idunmore/phi2/README.md

# phi2 - Retro/Homebrew Computer Focused Clock Generators

&nbsp;

**phi2** is a collection of breadboard-buildable, highly-flexible, clock generators for retro/homebrew computers, using a minimal number of inexpensive and readily available micro-controllers, SBCs and other parts.

### Why "phi2"?

This is a reference to the clock input on my favorite early CPU/MPU, the [6502](https://en.wikipedia.org/wiki/MOS_Technology_6502). While 6502-based builds are *my* current focus, the clock generators here can be used with effectively any CPU/computer build.

## Structure of this Repository

A simple mono-repo, with sub-projects on a per-build basis.

Due to the typically resource-constrained nature of the smaller microcontrollers, and significant differences between architectures and, even within a common architecture, different capabilities and pin-outs, shared code is likely to be limited.  Thus each project may be considered a self-contained whole, unless otherwise noted.  This helps minimize code size and complexity and improves code readability by avoiding the otherwise-necessary multiple levels of conditional compilation that would otherwise be required.

Each individual project will include both hardware build details and diagrams along with ready-to-run firmware/software.

## Clock Features

These will vary per-project.

### [nano-clock](nano-clock/)

This is the first project in the series.

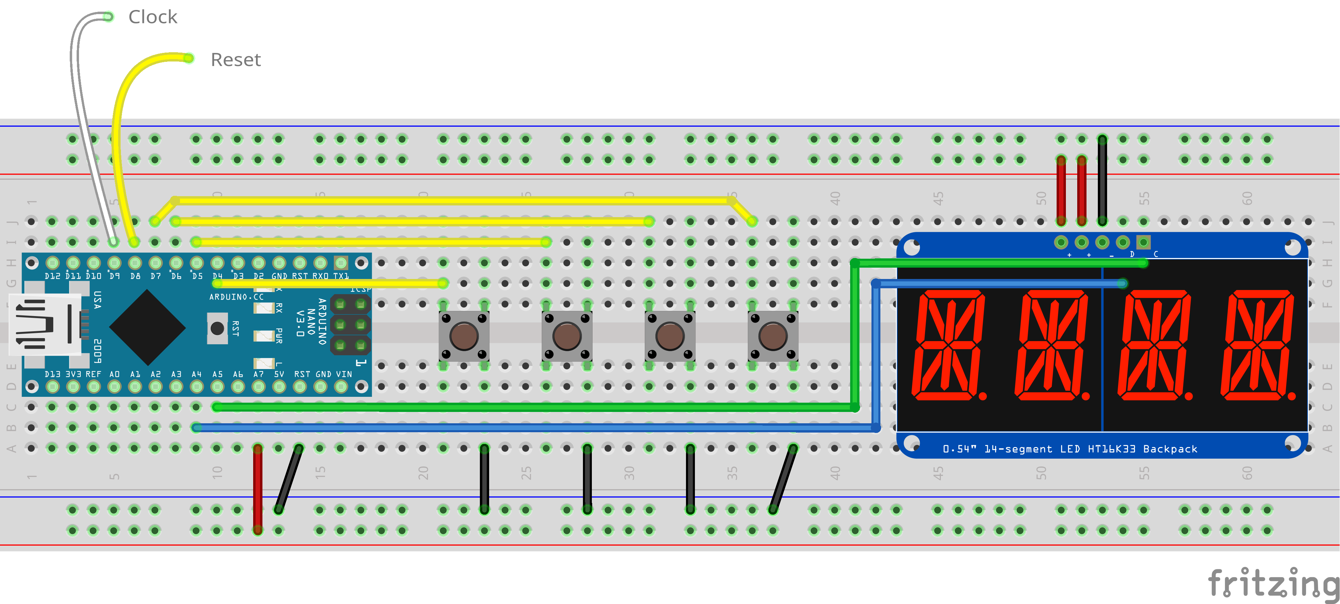
[picture p1: nano-clock/images/nano-clock_breadboard.png]
nano-clock breadboard layout


It has single-step and clock modes, run-stop toggle, selectable frequencies across three bands (Hz, kHz and MHz) in various increments from 1Hz to 8MHz, auto and manual reset functionality (with auto-reset on start option, configurable at run-time), a 14-segment 4-character LED status/info display (in keeping with the "retro" theme) with brightness control and run-time indicators.  This is a simple build, using just an Arduino Nano (an inexpensive clone will work fine) and four tactile buttons.

Advanced variations of this will incorporate different display technologies including tiny OLED and TFT color displays, and rich menu/graphical interfaces.

### [nano-clock-core](nano-clock-core/)

This 2nd, and almost the simplest (just the core capabilities), "phi2" project provides run-time selectable (and saveable) 1MHz, 2MHz, 4MHz and 8MHz clock frequencies, auto-starts when powered on, and offers a compile-time flag to enable/disable auto-reset behavior, and indicates operations using the built-in Arduino LED.  It requires only an Arduino Nano (or clone) and a single tactile button, which can be removed once an operating frequency has been selected and saved.

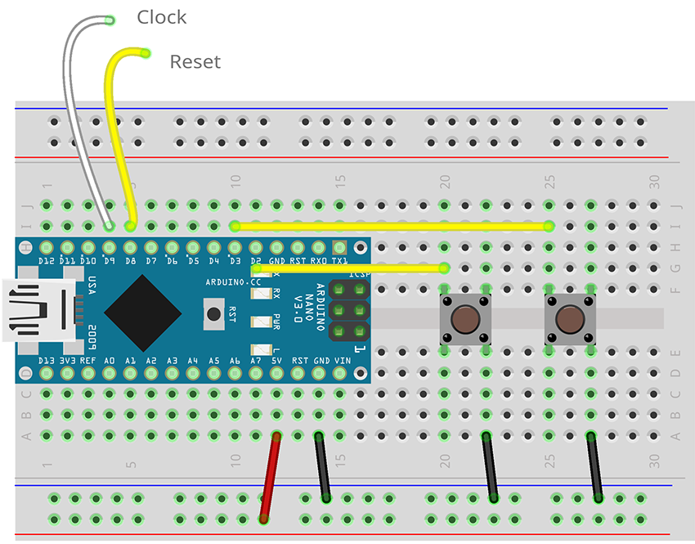
[picture p2: nano-clock-core/images/nano-clock-core_breadboard.png]
nano-clock-core breadboard layout


**nano-clock-core** is not much bigger than a standard 4-pin crystal oscillator can.

### [nano-clock-oled](nano-clock-oled/)

This is the 4th, and to-date most complex, "phi2" project.

It is based on my "[nano-clock](nano-clock/)" project, but instead of a 4-digit, 14-segment alphanumeric LED display it uses an small OLED panel on an I2C interface for status and operational messages. The initial version has the same functionality as the original, excepting a display on/off toggle in place of brightness control.

The display includes various status icons for which mode the clock is in (step vs. continuous clock), an animated waveform to indicate the clock is running, indicators for whether "reset on boot" is enabled, whether settings have been saved and if they've been changed since the last save.  And, finally, a large display that shows either the "step" pulse or the current clock frequency.

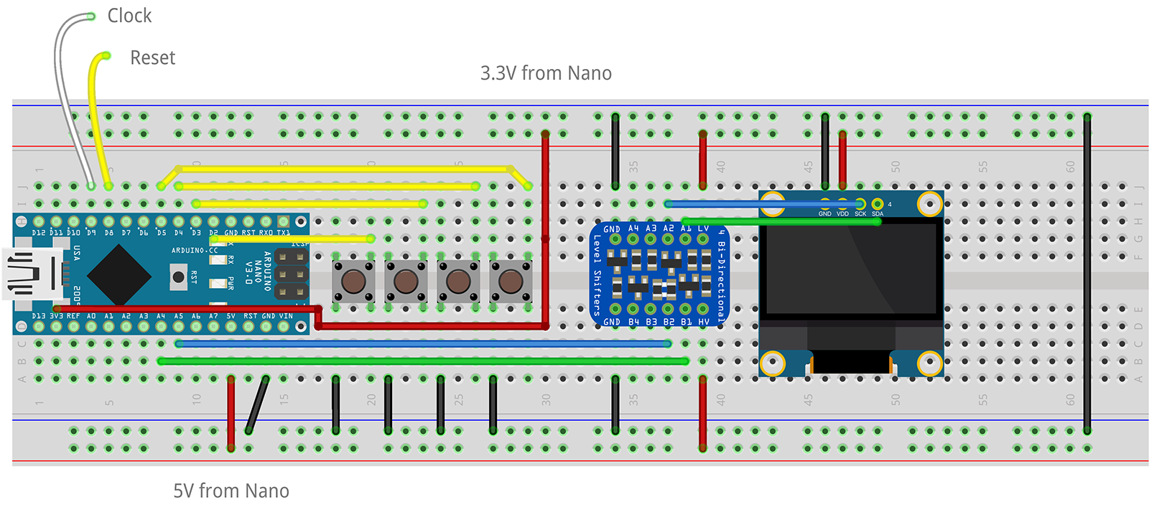
[picture p3: nano-clock-oled/images/nano-clock-oled_breadboard.png]
nano-clock-oled breadboard layout


### [tiny-clock](tiny-clock/)

The third clock build in the "phi2" series, and to date the simplest, departs from the typical "Arduino Board" based model and instead makes direct use of a "raw" microcontroller; in this case the [ATtiny85](https://ww1.microchip.com/downloads/en/DeviceDoc/Atmel-2586-AVR-8-bit-Microcontroller-ATtiny25-ATtiny45-ATtiny85_Datasheet.pdf).

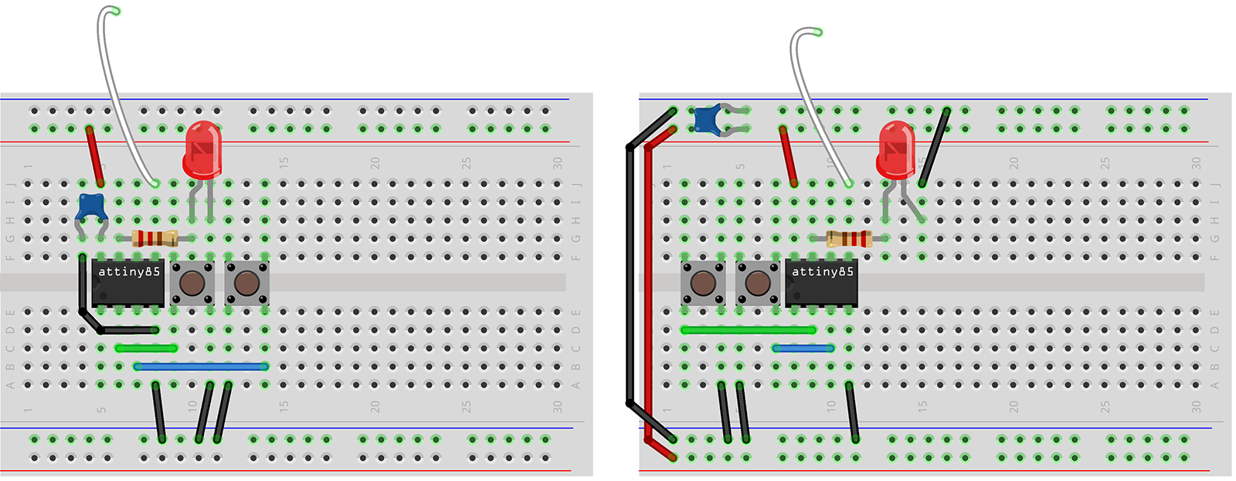
[picture p4: tiny-clock/images/tiny-clock_breadboard.png]
tiny-clock breadboard layout


The simplest build is **just** the ATTiny85 IC itself, an 8-pin DIP part that is **smaller** than the 4-pin crystal oscillator can in the standard BE6502 setup.  Optional, basic components (1 or 2 tactile buttons, and/or 1 resistor and LED), expand the basic clock generator behavior with run-time selectable (and saveable) 1MHz, 2MHz, 4MHz and 8MHz clock frequencies, an LED to indicate clock state/speed, and a single-step clock mode.

Settings can be saved by adding a button temporarily, and then can be removed.

## AI Usage

**None** for these projects, unless noted otherwise.

The goal wasn't to build them quickly, it was to have fun doing so and learn as much about the low-level hardware as possible.  That often means hand-optimized coding based on information buried deep in the datasheets for the raw microcontroller cores.

In most cases it also required a fair degree of manual tuning, changing values on the fly while observing output performance across several physical devices on a high-speed oscilloscope.  Variations within quoted tolerance are readily visible here.
