idunmore/phi2/nano-clock-oled/README.md

# nano-clock-oled - Arduino Nano based System Clock Gen

&nbsp;

**nano-clock-oled** is the fourth project in the "phi2" series.

It is based on my "[nano-clock](https://github.com/idunmore/phi2/tree/main/nano-clock)" project, but instead of a 4-digit, 14-segment alphanumeric LED display it uses an small OLED panel on an I2C interface for status and operational messages.  The initial version has the same functionality as the original, excepting a display on/off toggle in place of brightness control. Future iterations may add additional features or change display aesthetics, depending on available microcontroller RAM.

It provides a more flexible alternative to [Ben Eater's](https://eater.net) [6502 clock-module](https://eater.net/6502), both for single-step and slow-cycle operations as well as the ability to replace the final build's 1MHz crystal oscillator while offering faster clock speeds.

nano-clock-oled breadboard layout

## Features

- Single-step and Clock modes
- Run/Stop toggle
- Selectable frequencies across three bands (Hz, kHz and MHz)
  - Hz Band - 1, 2, 5, 10, 25, 50, 100, 250 & 500Hz
  - kHz Band - 1, 2, 5, 10, 25, 50, 100, 250 & 500kHz
  - MHz Band - 1, 2, 4, 8MHz
  - Easy to add additional bands/frequencies
- Auto and manual CPU reset functionality
  - w/ Auto-reset on Start option
- 128x64 pixel OLED status/info display
  - Display ON/OFF control
  - Clock-Running and Status indication
- Save Settings for Auto-Start

## Status

**nano-clock-oled** uses the core "clock" and "features" implementation from my original [nano-clock](https://github.com/idunmore/phi2/tree/main/nano-clock) project.  These are _feature complete_, though not thoroughly tested yet.

Status display (top line) and "running" waveforms are fully implemented.

An optional (disable by setting HEART_BEAT_RATE to 0) "heartbeat", separate from the clock-pulse operation, is provided to allow easy determination of whether the clock is responding to input.

A "saved settings" indicator has been added (gear icon).  If present, settings have been saved.  If saved settings are present, an additional icon (check, uncheck) indicates if any settings have been changed since they were last saved.

Note that the Arduino Nano has only 2KB of RAM, **half** of which would be required just to buffer the OLED display (and then doesn't leave enough for the remainder of the program), so **u8g2**'s "paged mode" is used.  Even in paged mode, it was necessary to move all tables and labels/strings into PROGMEM.  The display "~776" bytes of available RAM shown on compile is misleading; at least 384 bytes are needed beyond this, at runtime, for dynamically allocated buffers and heap items, and prior to moving things to PROGMEM there was only 374 available!

## Optimizations

I've been through the code several times making various changes to a) reduce the overall amount of code, b) simplify the code that remains, c) improve performance and d) reduce the memory footprint (FLASH and SRAM) of the build.

Optimizations include a single point of display update, simplification of the band and frequency tables (including eliminating index values and next-frequency points, and using modulo division to provide wrap-around of values instead of conditionals).  Moving text labels into FLASH (PROGMEM), using a custom "only those characters required" font (and a tool to regenerate it, see "tools/").  Simplified general logic.  And inlining more behavior and some string literals (via PSTR, from FLASH).

The font-space reduction isn't strictly necessary; the full fonts fit within the 32KB of available FLASH memory, however since I was optimizing things I spent the time to do these also, so it's already handled if I add more functionality or want to use a smaller/custom board that has less flash available.

Finally, I defaulted the u8g2 display constructor, and removed the supporting, explicit, #define addresses and I2C pin assignments, since the default behavior gets this correct both for the Arduino Nano but also other boards (where those values would then have to be changed in the **nano-clock-oled** code).

## Usage

### Connecting to your Computer

Ensure you tie the GND (black) busses to the common GND for your computer board.  If you also connect the +5V busses to your computer's supply, it can power both itself and the **nano-clock-oled**.  Then connect the CLOCK pin (9) on the **nano-clock** to the clock pin on your computer's CPU/MPU.  In the case of the Ben Eater WDC65C02 based computer, this would be **phi2** (pin 37).

If you want RESET functionality as well, connect the RESET pin (8) on the **nano-clock-oled** to the RESET pin on your computer's CPU/MPU.  RESET is a LOW trigger, so the line will be high when not resetting (no pull-up resistor should be required).

### User Interface/Controls

The interface for **nano-clock-oled** comprises four buttons and a 128x64 pixed graphics-capable OLED display.  Each button has two functions, driven by a short-press (<999ms) or a long-press (>=1s).  From left to right, the button functions are as follows:

#### Button 1 - Step/Run Toggle | Step vs. Clock Mode

A long press switches between **Single Step** mode (STEP) and **Clock** (CLCK) mode.

Depending on the mode, a short press does one of two things:

- In Step mode, pressing button one generates a single clock pulse.  This is indicated by the periods on the LED display illuminating.
- In Clock mode, it toggles between Run (starting) and Stop (stopping) behavior for the clock.

#### Button 2 - Frequency Select | Frequency Band Select

- A short press steps through the available frequencies in the current frequency band.
- A long press steps through the available frequency bands (Hz, kHz and MHz).

In both cases, if you reach the end of the available frequencies or bands, the next press will take you back to the first.

#### Button 3 - Reset | Auto Reset Toggle

- A short press generates a RESET event (brings the RESET PIN to LOW for the duration specified; default is 2ms per the WDC65C02).
- A long press toggles between RstON and RstOFF, which determine whether a RESET cycle is executed when the nano-clock first powers on.  This is used to allow nano-clock-oled to control initial power on and clock management.  Note that this value only has an effect if it is SAVED.

#### Button 4 - Display On/Off | Save Settings

- A short press steps toggles the OLED display ON and Off.  This setting _is_ saved, so bear that in mind if you power up and find there is no display shown. 
- A long press SAVEs the current state of **nano-clock-oled** to EEPROM.  This will be reloaded on a reset or power off/on cycle so that **nano-clock-oled** can be used to both reset and initiate operation of a machine without further interaction.

*Note:* If you want **nano-clock-oled** to automatically start from cold/reset with the clock RUNNING, you must perform the SAVE while the clock is in Run mode and RUN is toggled on (clock mode shows running and the waveform is animated).

## Dependencies

A formal dependency list, with minimum versions, will be added here prior to the first stable release, however the basic library dependencies are:

- EasyButton (v2.0.3)
- 8u2g (v2.36.19)

## Building a NANO-CLOCK-OLED

### Components

A minimal number of components are required to assemble **nano-clock**:

- Arduino Nano v3.0 (clones are fine; must match official pinout)
- 4x 6x6mm Momentary Tactile Switches
- 0.96" OLED Display w/ I2C Interface
  - 5v -> 3.3v Level Shifters (only required for 3.3v OLED displays)
- 830 Point Solderless Breadboard

I used an [Elegoo Arduino Nano v3.0](https://www.amazon.com/ELEGOO-Presoldered-Compatible-Arduino-Microcontroller/dp/B0F6Y7GS4Q/), since they are cheap and have a USB-C connector (they have options for other connectors, so verify which version you order).

The actual OLED display used, other than requiring an I2C interface and a 128x64 pixel, pixel-addressable, display, is up to the user.  Some have [integrated buttons](https://www.amazon.com/dp/B0GWQYFTQD) (that read as separate physical momentary switches), and various size options are available.

### Assembly

**NOTE:** The depicted "schematic" assumes the power input is via the USB connection on the Arduino Nano.  GND is common.  +5V is on the bottom power rail, drawn from the Nano's 5V pin.  +3.3V is on the top power rail, drawn from the Nano's 3.3V pin.  If powering via an external supply, or from another board, you will need to ensure either a) you have a 3.3V feed from that board for the top rails or b) you're powering the Nano via it's VIN line or c) you use an OLED display with built-in level shifting circuitry or 5V tolerance (and then just use a common +5V feed on both rails).

The breadboard "schematic", above, shows all of the required connections.  In an actual build, you can run the non-ground connections to the Arduino Nano *under* the board (since it is on headers) for a cleaner and more secure fit.  Similarly, the SDA and SCL connections to the LED display can be run under the OLED's PCB.

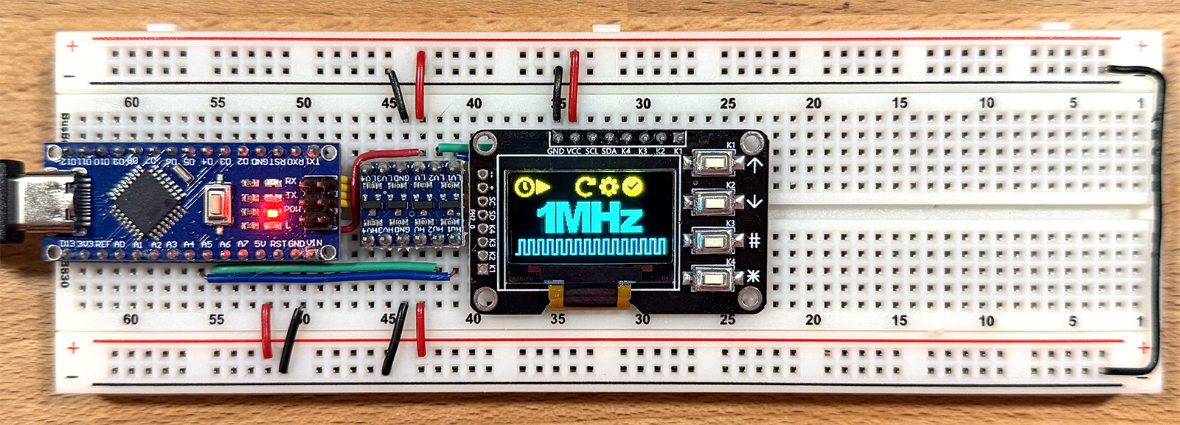
[picture p5: nano-clock-oled/images/nano-clock-oled_actual.jpg]
nano-clock-oled breadboard layout


### Programming the Arduino Nano

Install the libraries described in "Dependencies" via the Arduino IDE, connect your board to your computer and choose the appropriate connection and board type ("Arduino Nano"), load the `nano-clock-oled.ino` file, and click "Upload".  The sketch will be verified, compiled, and uploaded to your Arduino Nano.

If everything has worked, after a brief pause, the OLED display should show "1Hz".

That's it.
