idunmore/phi2/(commit log)

2026-10-11 Add usage and assembly instructions
2026-10-16 Add breadboard assembly
2026-10-16 Remove Serial.println() calls
2026-11-02 Update 5V/3.3V on schematic/README
2026-11-05 Add picture of actual board
